lucjross/weejeebot/img.png

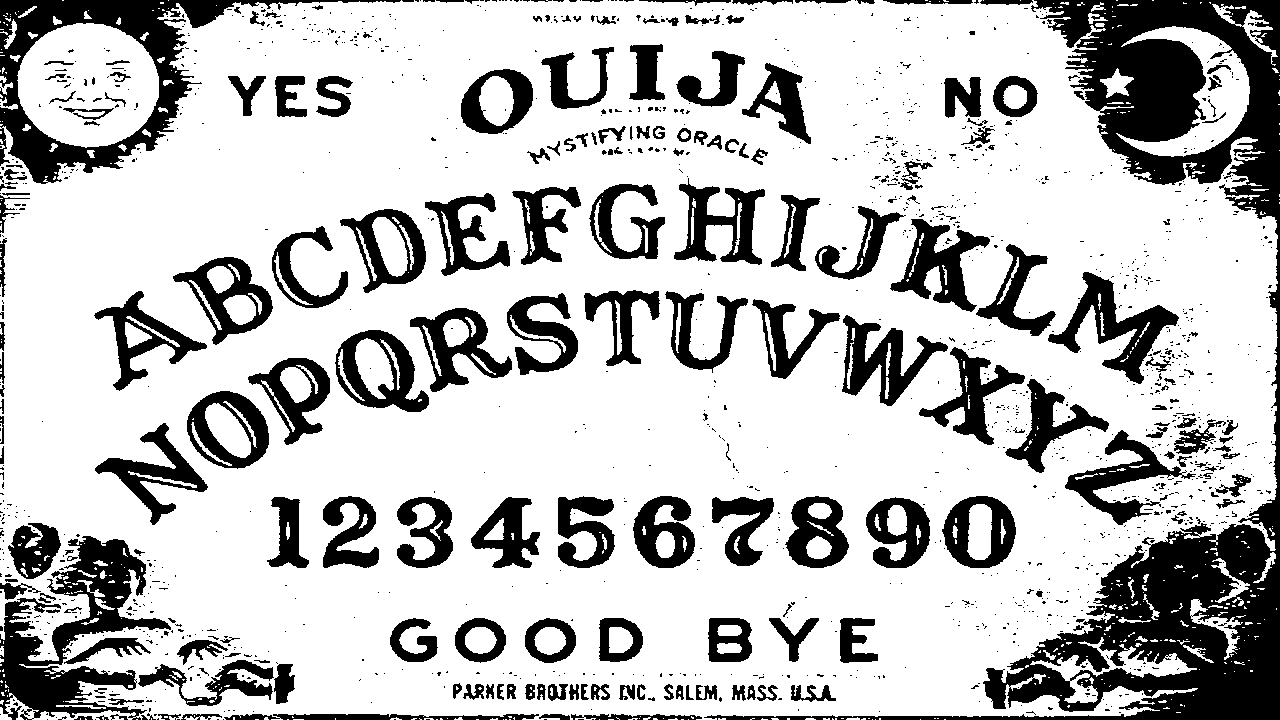
img.png
