lucjross/weejeebot/template.png

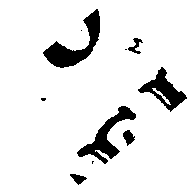
template.png
