lucjross/weejeebot/(commit log)

2022-10-29 rename arduino files
2026-10-10 Rewrite wiring doc for the ultrasonic design; add backend skeleton and handoff notes
    - arduino/WIRING.md: wiring for four HC-SR04 sonars (diode-OR shared echo with pull-down),
    Uno-Nano serial link through the level converter, Nano 33 IoT and GC9A01 display,
    orientation and physical layout.
    - Remove img.png (not the real board).
    - backend/: Gradle project skeleton plus TRANSCRIPTION_HANDOFF.md, notes for replacing the
    Amazon Transcribe speech-to-text.
2026-10-17 Port remote test harness to the ultrasonic sensors and calibrate them
    - remote_test: replace the VL53L0X/PCF8575 code with a sonar module (4x HC-SR04,
    two shared echo lines), update guards, telemetry, host client and tests;
    drop the ToF-only quality data and the t04 A/B test
    - Split the echo line per axis (front/back on A2, left/right on A1) in
    zumo_avr and the wiring doc; document the required pull-downs
    - Add sonar_test bench sketch and script
    - Add per-sensor gain/offset correction fitted against tape measurements
    (host/data/accuracy.csv)
    - Board height 56.83 cm (measured)
2026-10-17 Add motion sweep test, drive ramp, and per-pair sonar offsets
    - t05_sweep.py: drive along x in short steps inside the original zumo_avr
    margins, record the sonars at each stop, report pair sums, gain ratio and
    sideways/yaw drift; --ramp and --trim options (trim defaults to 0.086,
    estimated from a run at 200/182 with a 400 ms ramp)
    - uno_remote: optional ramp argument on DRIVE (linear ramp from 0)
    - rc.py: retry GETs on WiFi blips (never POSTs), optional ramp on drive();
    mock robot gets a simple x-axis motion model
    - Sonar correction: drop the tape-fitted gains (they made the F+B and R+L
    sums less consistent across positions); use offsets derived from the bot's
    measured body size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
2026-10-17 Add sonar frame OpenSCAD model
2026-10-17 Add display_test sketch for the GC9A01 screen
    Colour sweep, outline and orientation marker, and a running counter. No WiFi
    and no Uno link, so it checks only the display and its wiring.
2026-10-18 Rewrite the Nano firmware with a busy state and plain WiFiNINA
    - Same HTTP API (/heyOuija, /answer, /tryAgain), plus GET /status; /answer and
    /tryAgain answer 409 while the bot is still spelling the previous answer
    - Busy ends when the Uno has reached every point ($arrived) or sent $smiley();
    4 minute timeout; optional POST /bot/idle to the backend (BACKEND_HOST in
    secrets.h)
    - Points go out of a queue every 500 ms instead of one arduino-timer task per
    letter (the library holds 16), which also drops the stray "Serial1." that
    stopped the old sketch compiling
    - Plain WiFiNINA with a small request parser, percent-decoded form fields,
    WiFi reconnect in loop
    - New display messages: $o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
2026-10-18 Split zumo_avr into modules and rework the heading and calibration
    - Split the single sketch into config, types, globals, sonar, position,
    compass, link and moves; function bodies unchanged apart from the fixes below
    - Fix COORD_UNDEF (-32768 wrapped to 0 in an int8_t, so an undefined position
    became (0, 0)); remove the broken debug print
    - Fix headingOf, whose uint16_t angle could never be negative, so headings past
    180 degrees wrapped to ~65000
    - Apply the per-sensor sonar offsets, rounding to the nearest cm instead of
    truncating
    - Compass calibration spins in pulses and reads the magnetometer in the pauses
    (the motors disturb it), until the gyro reports a full turn plus margin;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
2026-10-20 Uno: move along the board's axes with the sonars, ping them in pairs, tighten turns
    Replaces the diagonal turn-go-turn planner with axis moves: square up to
    heading 0, drive along x until the F/B sonar reaches the target, or turn to
    90 and do the same along y. Drives run in bursts, slow near the target and
    stay on one sensor. The sonars fire in perpendicular pairs (F+R, B+L) every
    30 ms, not during turns, with unrounded mm readings for the drive. Turns
    aim past the target and are tolerant at rest (2 deg to turn, 8 deg for 1 s
    to move again), and the motor loop runs every 20 ms.
